TiZed/KReal/KReal.pdf

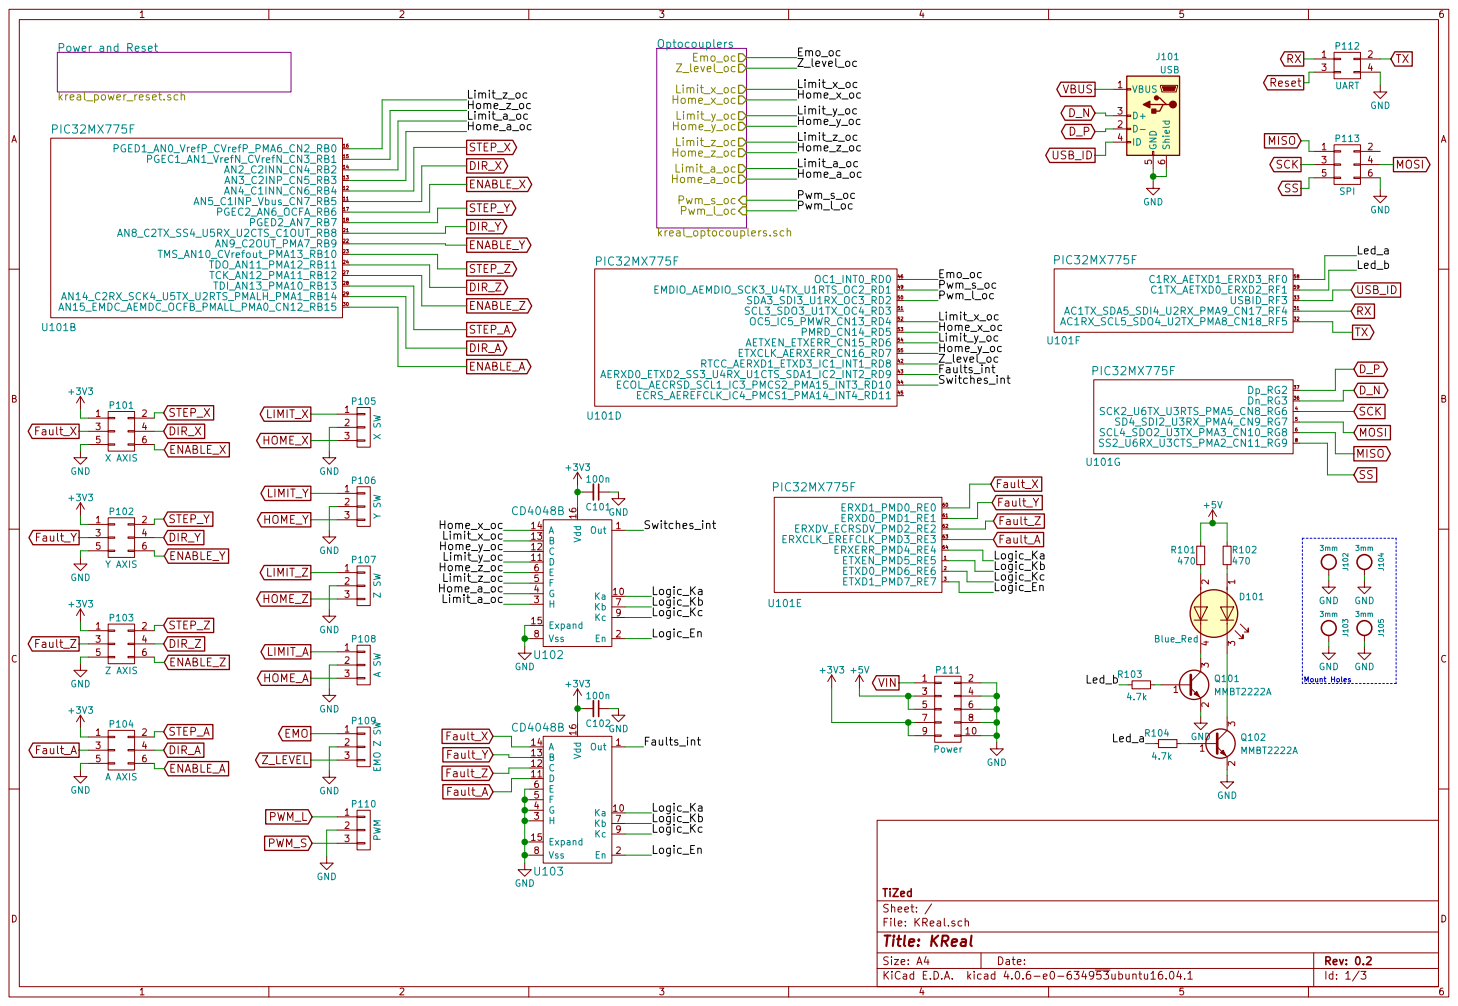
[picture p1: page 1]

Id: 1/3 Title: KReal File: KReal.sch Sheet: / TiZed Fault_X

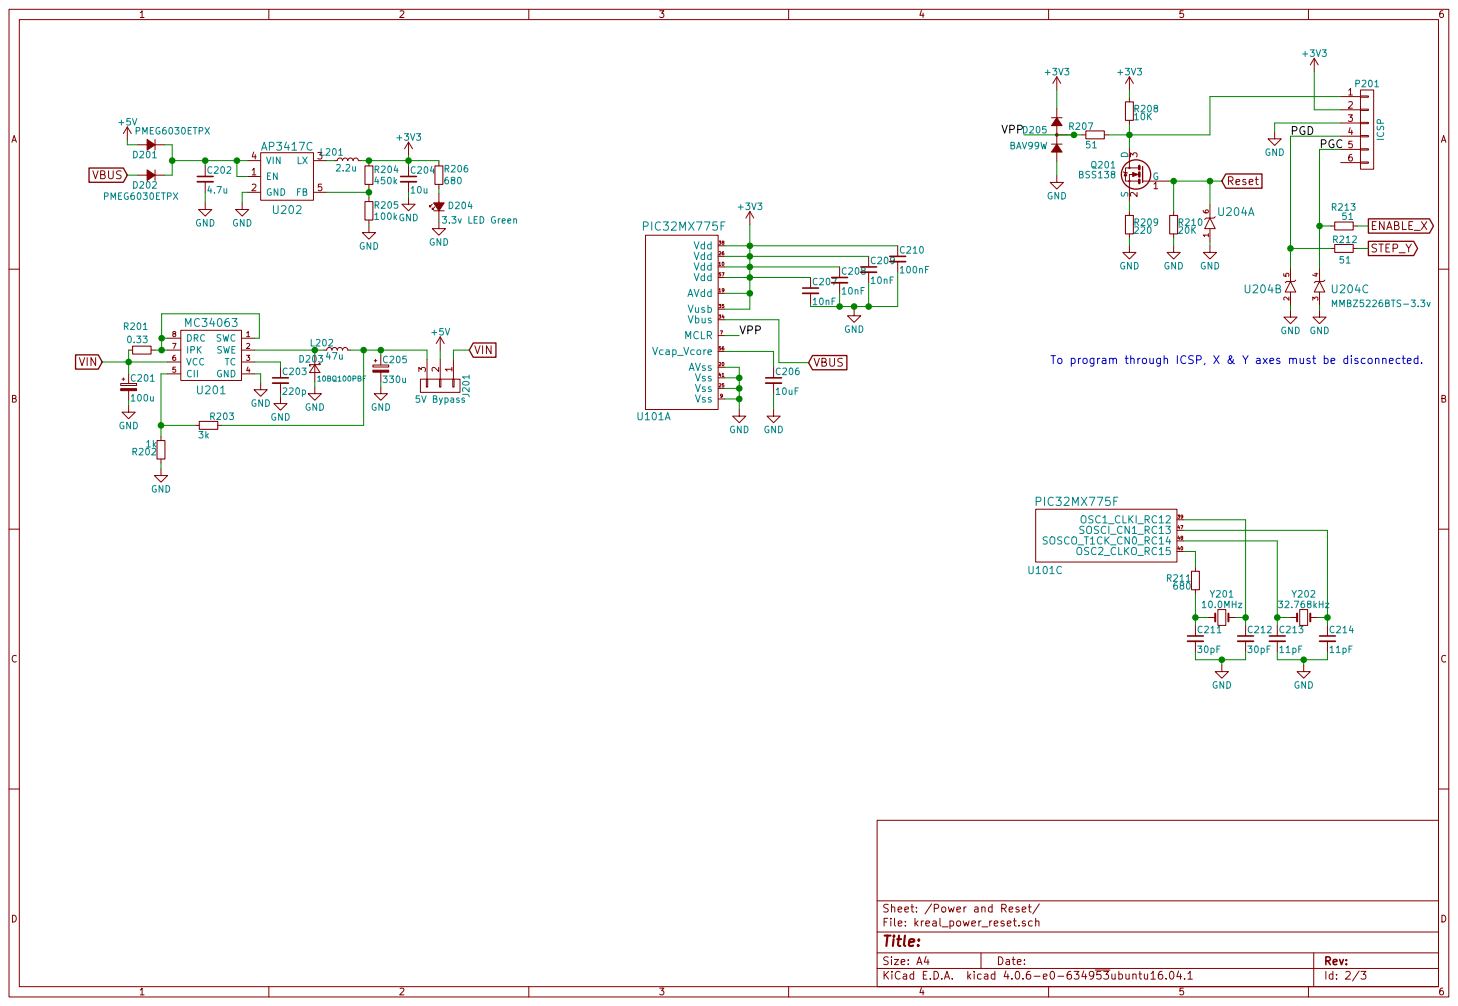
[picture p2: page 2]

10.0MHz To program through ICSP, X & Y axes must be disconnected.

File: kreal_power_reset.sch Sheet: /Power and Reset/
Id: 2/3 Title:

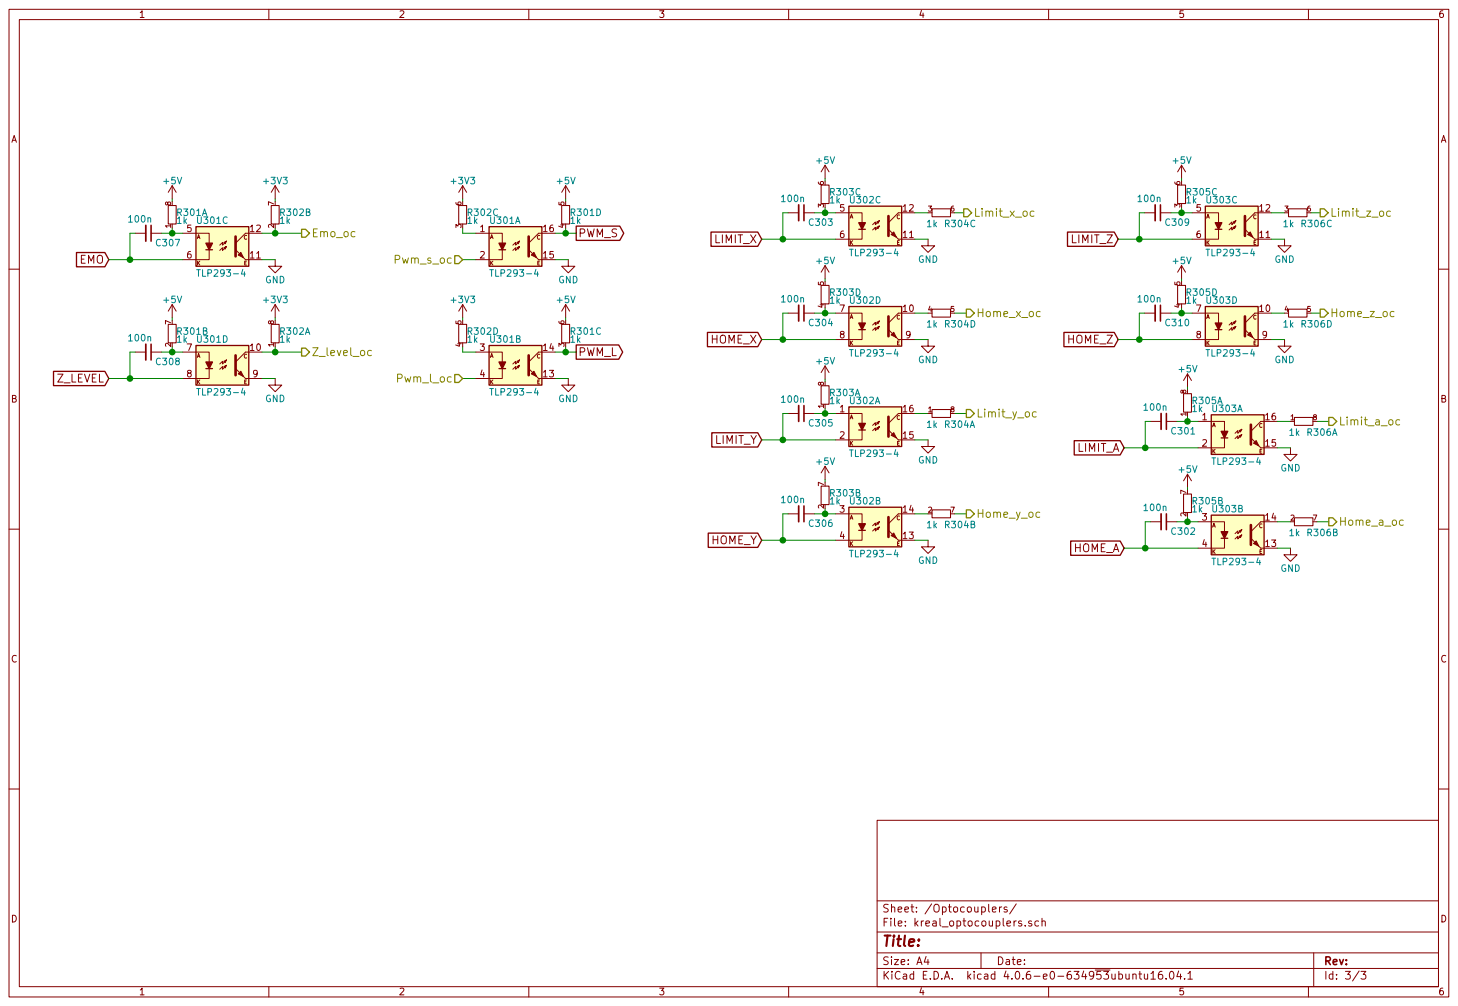
[picture p3: page 3]
