TiZed/KReal/KReal.kicad_pcb

## KiCad design KReal.kicad_pcb (2017-09-15)

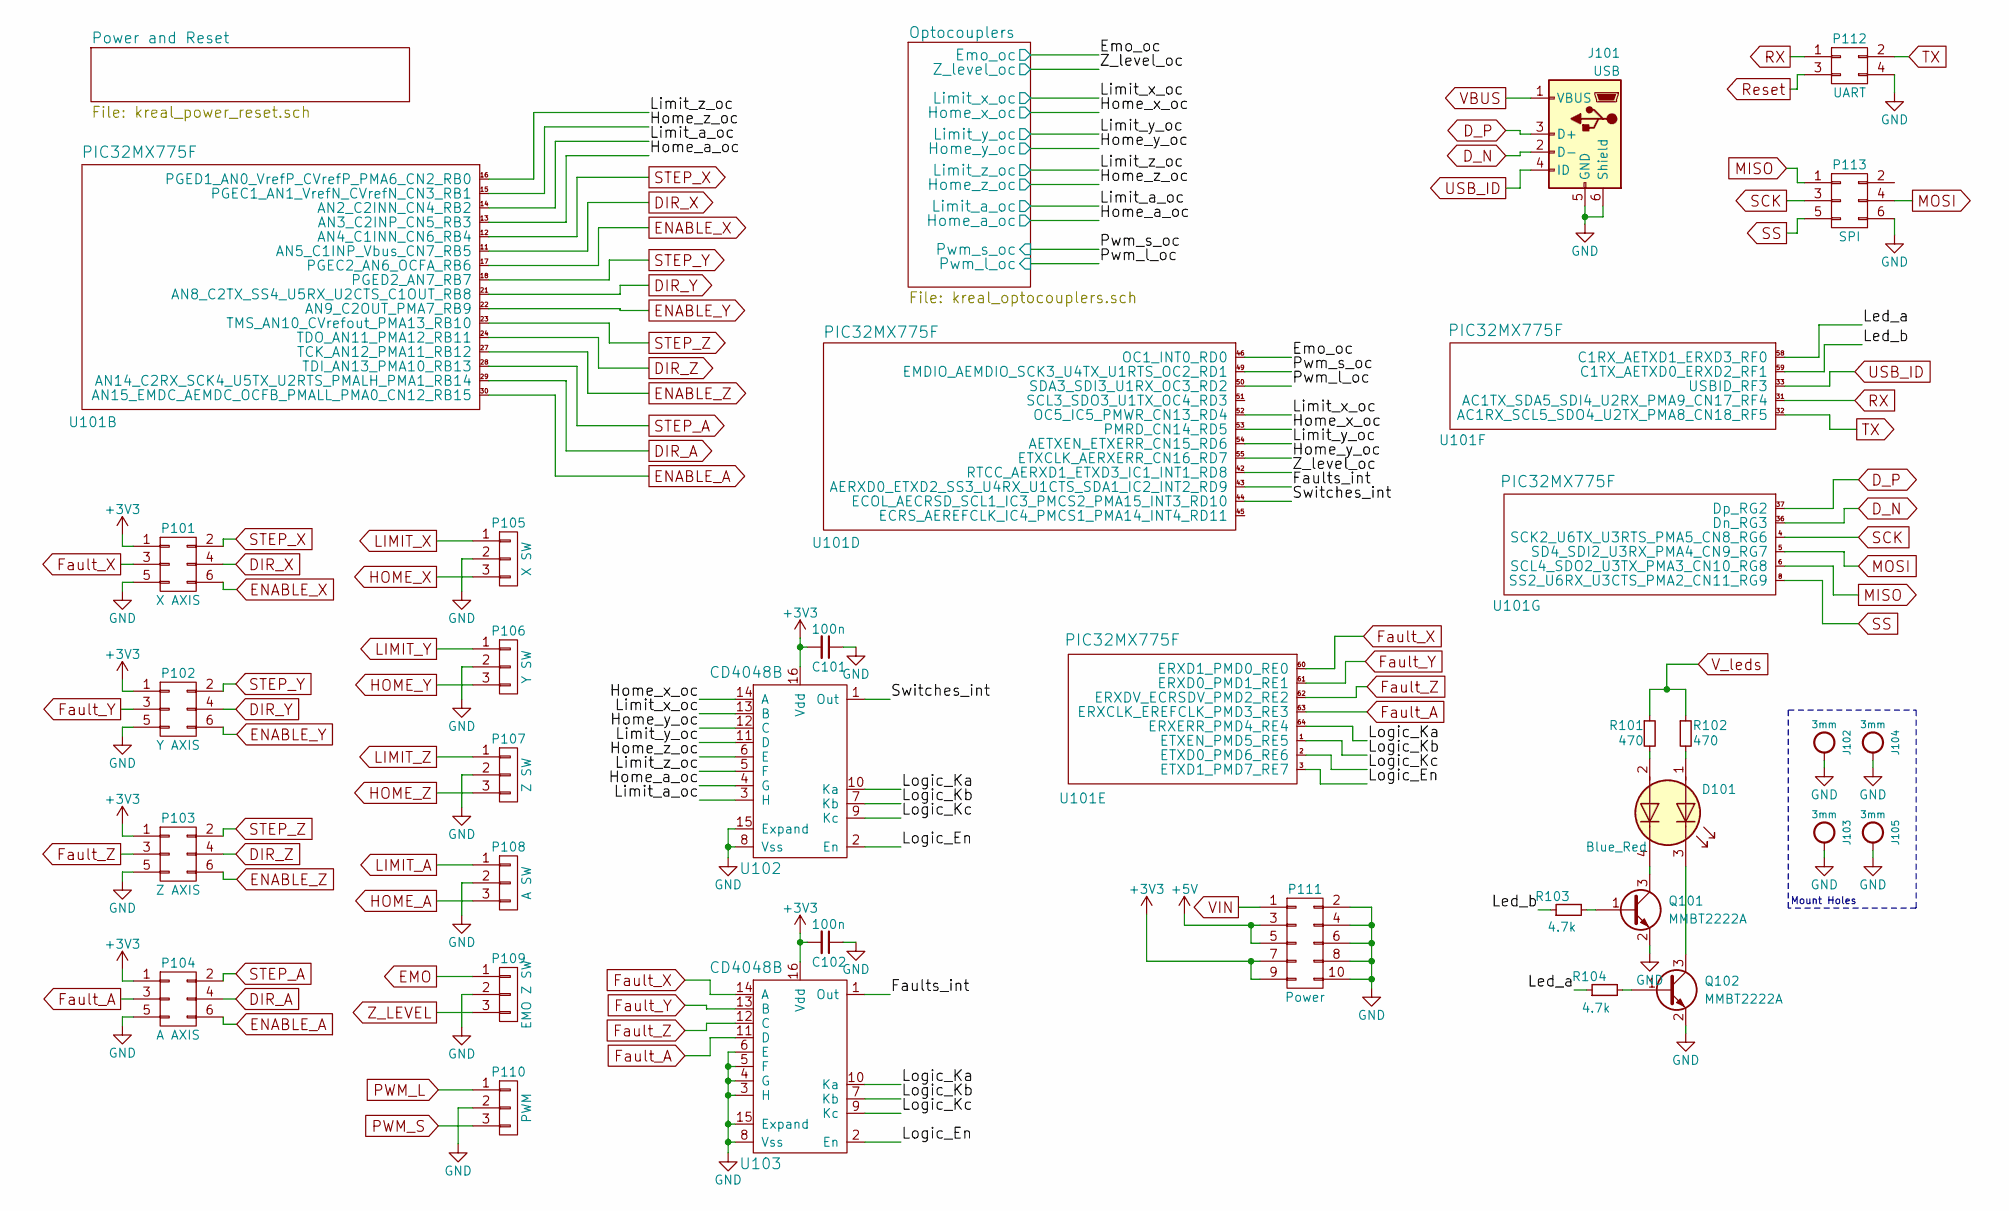
[picture p4: schematic KReal.sch]

Parts:
C101, C102: 100n; C_0603
D101: Blue_Red; LEDs_AACC_1.6mm_1.5mm
J101: USB; USB_Mini-B
J102, J103, J104, J105: 3mm; MountingHole_3mm_Pad
P101: X AXIS; Pin_Header_Straight_2x03_Pitch2.54mm
P102: Y AXIS; Pin_Header_Straight_2x03_Pitch2.54mm
P103: Z AXIS; Pin_Header_Straight_2x03_Pitch2.54mm
P104: A AXIS; Pin_Header_Straight_2x03_Pitch2.54mm
P105: X SW; Pin_Header_Straight_1x03_Pitch2.54mm
P106: Y SW; Pin_Header_Straight_1x03_Pitch2.54mm
P107: Z SW; Pin_Header_Straight_1x03_Pitch2.54mm
P108: A SW; Pin_Header_Straight_1x03_Pitch2.54mm
P109: EMO Z SW; Pin_Header_Straight_1x03_Pitch2.54mm
P110: PWM; Pin_Header_Straight_1x03_Pitch2.54mm
P111: Power; Pin_Header_Straight_2x05_Pitch2.54mm
P112: UART; Pin_Header_Straight_2x02_Pitch2.54mm
P113: SPI; Pin_Header_Straight_2x03_Pitch2.54mm
Q101, Q102: MMBT2222A; SOT-23
R101, R102: 470; R_0603
R103, R104: 4.7k; R_0603
U101: PIC32MX775F; TQFP-64_10x10mm_Pitch0.5mm
U102, U103: CD4048B; TSSOP-16_4.4x5mm_Pitch0.65mm

Connections:
+3V3: C101.2, C102.2, P101.1, P102.1, P103.1, P104.1, P111.7, P111.9, U102.16 (Vdd), U103.16 (Vdd); also elsewhere on the board
+5V: P111.3, P111.5; also elsewhere on the board
/Emo_oc: U101.46 (OC1_INT0_RD0); also elsewhere on the board
/Faults_int: U101.43 (AERXD0_ETXD2_SS3_U4RX_U1CTS_SDA1_IC2_IN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), U103.1 (Out)
/Home_a_oc: U101.13 (AN3_C2INP_CN5_RB3), U102.4 (G); also elsewhere on the board
/Home_x_oc: U101.53 (PMRD_CN14_RD5), U102.14 (A); also elsewhere on the board
/Home_y_oc: U101.55 (ETXCLK_AERXERR_CN16_RD7), U102.12 (C); also elsewhere on the board
/Home_z_oc: U101.15 (PGEC1_AN1_VrefN_CVrefN_CN3_RB1), U102.6 (E); also elsewhere on the board
/Led_a: R104.1, U101.58 (C1RX_AETXD1_ERXD3_RF0)
/Led_b: R103.1, U101.59 (C1TX_AETXD0_ERXD2_RF1)
/Limit_a_oc: U101.14 (AN2_C2INN_CN4_RB2), U102.3 (H); also elsewhere on the board
/Limit_x_oc: U101.52 (OC5_IC5_PMWR_CN13_RD4), U102.13 (B); also elsewhere on the board
/Limit_y_oc: U101.54 (AETXEN_ETXERR_CN15_RD6), U102.11 (D); also elsewhere on the board
/Limit_z_oc: U101.16 (PGED1_AN0_VrefP_CVrefP_PMA6_CN2_RB0), U102.5 (F); also elsewhere on the board
/Logic_En: U101.3 (ETXD1_PMD7_RE7), U102.2 (En), U103.2 (En)
/Logic_Ka: U101.64 (ERXERR_PMD4_RE4), U102.10 (Ka), U103.10 (Ka)
/Logic_Kb: U101.1 (ETXEN_PMD5_RE5), U102.7 (Kb), U103.7 (Kb)
/Logic_Kc: U101.2 (ETXD0_PMD6_RE6), U102.9 (Kc), U103.9 (Kc)
/Pwm_l_oc: U101.50 (SDA3_SDI3_U1RX_OC3_RD2); also elsewhere on the board
/Pwm_s_oc: U101.49 (EMDIO_AEMDIO_SCK3_U4TX_U1RTS_OC2_RD1); also elsewhere on the board
/Switches_int: U101.44 (ECOL_AECRSD_SCL1_IC3_PMCS2_PMA15_INT3_R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), U102.1 (Out)
/Z_level_oc: U101.42 (RTCC_AERXD1_ETXD3_IC1_INT1_RD8); also elsewhere on the board
DIR_A: P104.4, U101.29 (AN14_C2RX_SCK4_U5TX_U2RTS_PMALH_PMA1_RB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)
DIR_X: P101.4, U101.11 (AN5_C1INP_Vbus_CN7_RB5)
DIR_Y: P102.4, U101.21 (AN8_C2TX_SS4_U5RX_U2CTS_C1OUT_RB8)
DIR_Z: P103.4, U101.24 (TDO_AN11_PMA12_RB11)
D_N: J101.2 (D-), U101.36 (Dn_RG3)
D_P: J101.3 (D+), U101.37 (Dp_RG2)
EMO: P109.1; also elsewhere on the board
ENABLE_A: P104.6, U101.30 (AN15_EMDC_AEMDC_OCFB_PMALL_PMA0_CN12_RB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)
ENABLE_X: P101.6, U101.17 (PGEC2_AN6_OCFA_RB6); also elsewhere on the board
ENABLE_Y: P102.6, U101.22 (AN9_C2OUT_PMA7_RB9)
ENABLE_Z: P103.6, U101.27 (TCK_AN12_PMA11_RB12)
Fault_A: P104.3, U101.63 (ERXCLK_EREFCLK_PMD3_RE3), U103.11 (D)
Fault_X: P101.3, U101.60 (ERXD1_PMD0_RE0), U103.14 (A)
Fault_Y: P102.3, U101.61 (ERXD0_PMD1_RE1), U103.13 (B)
Fault_Z: P103.3, U101.62 (ERXDV_ECRSDV_PMD2_RE2), U103.12 (C)
GND: C101.1, C102.1, J101.5 (GND), J101.6 (Shield), J102.1, J103.1, J104.1, J105.1, P101.5, P102.5, P103.5, P104.5, P105.2, P106.2, P107.2, P108.2, P109.2, P110.2, P111.2, P111.4, P111.6, P111.8, P111.10, P112.4, P113.6, Q101.2 (E), Q102.2 (E), U102.8 (Vss), U102.15 (Expand), U103.3 (H), U103.4 (G), U103.5 (F), U103.6 (E), U103.8 (Vss), U103.15 (Expand); also elsewhere on the board
HOME_A: P108.3; also elsewhere on the board
HOME_X: P105.3; also elsewhere on the board
HOME_Y: P106.3; also elsewhere on the board
HOME_Z: P107.3; also elsewhere on the board
LIMIT_A: P108.1; also elsewhere on the board
LIMIT_X: P105.1; also elsewhere on the board
LIMIT_Y: P106.1; also elsewhere on the board
LIMIT_Z: P107.1; also elsewhere on the board
MISO: P113.1, U101.6 (SCL4_SDO2_U3TX_PMA3_CN10_RG8)
MOSI: P113.4, U101.5 (SD4_SDI2_U3RX_PMA4_CN9_RG7)
unnamed: D101.1 (A1), R102.2
unnamed: D101.2 (A2), R101.2
unnamed: D101.3 (K1), Q102.3 (C)
unnamed: D101.4 (K2), Q101.3 (C)
unnamed: Q101.1 (B), R103.2
unnamed: Q102.1 (B), R104.2
PWM_L: P110.1; also elsewhere on the board
PWM_S: P110.3; also elsewhere on the board
RX: P112.1, U101.31 (AC1TX_SDA5_SDI4_U2RX_PMA9_CN17_RF4)
Reset: P112.3; also elsewhere on the board
SCK: P113.3, U101.4 (SCK2_U6TX_U3RTS_PMA5_CN8_RG6)
SS: P113.5, U101.8 (SS2_U6RX_U3CTS_PMA2_CN11_RG9)
STEP_A: P104.2, U101.28 (TDI_AN13_PMA10_RB13)
STEP_X: P101.2, U101.12 (AN4_C1INN_CN6_RB4)
STEP_Y: P102.2, U101.18 (PGED2_AN7_RB7); also elsewhere on the board
STEP_Z: P103.2, U101.23 (TMS_AN10_CVrefout_PMA13_RB10)
TX: P112.2, U101.32 (AC1RX_SCL5_SDO4_U2TX_PMA8_CN18_RF5)
USB_ID: J101.4 (ID), U101.33 (USBID_RF3)
VBUS: J101.1 (VBUS); also elsewhere on the board
VIN: P111.1; also elsewhere on the board
V_leds: R101.1, R102.1; also elsewhere on the board
Z_LEVEL: P109.3; also elsewhere on the board

Notes on the sheet:
Mount Holes

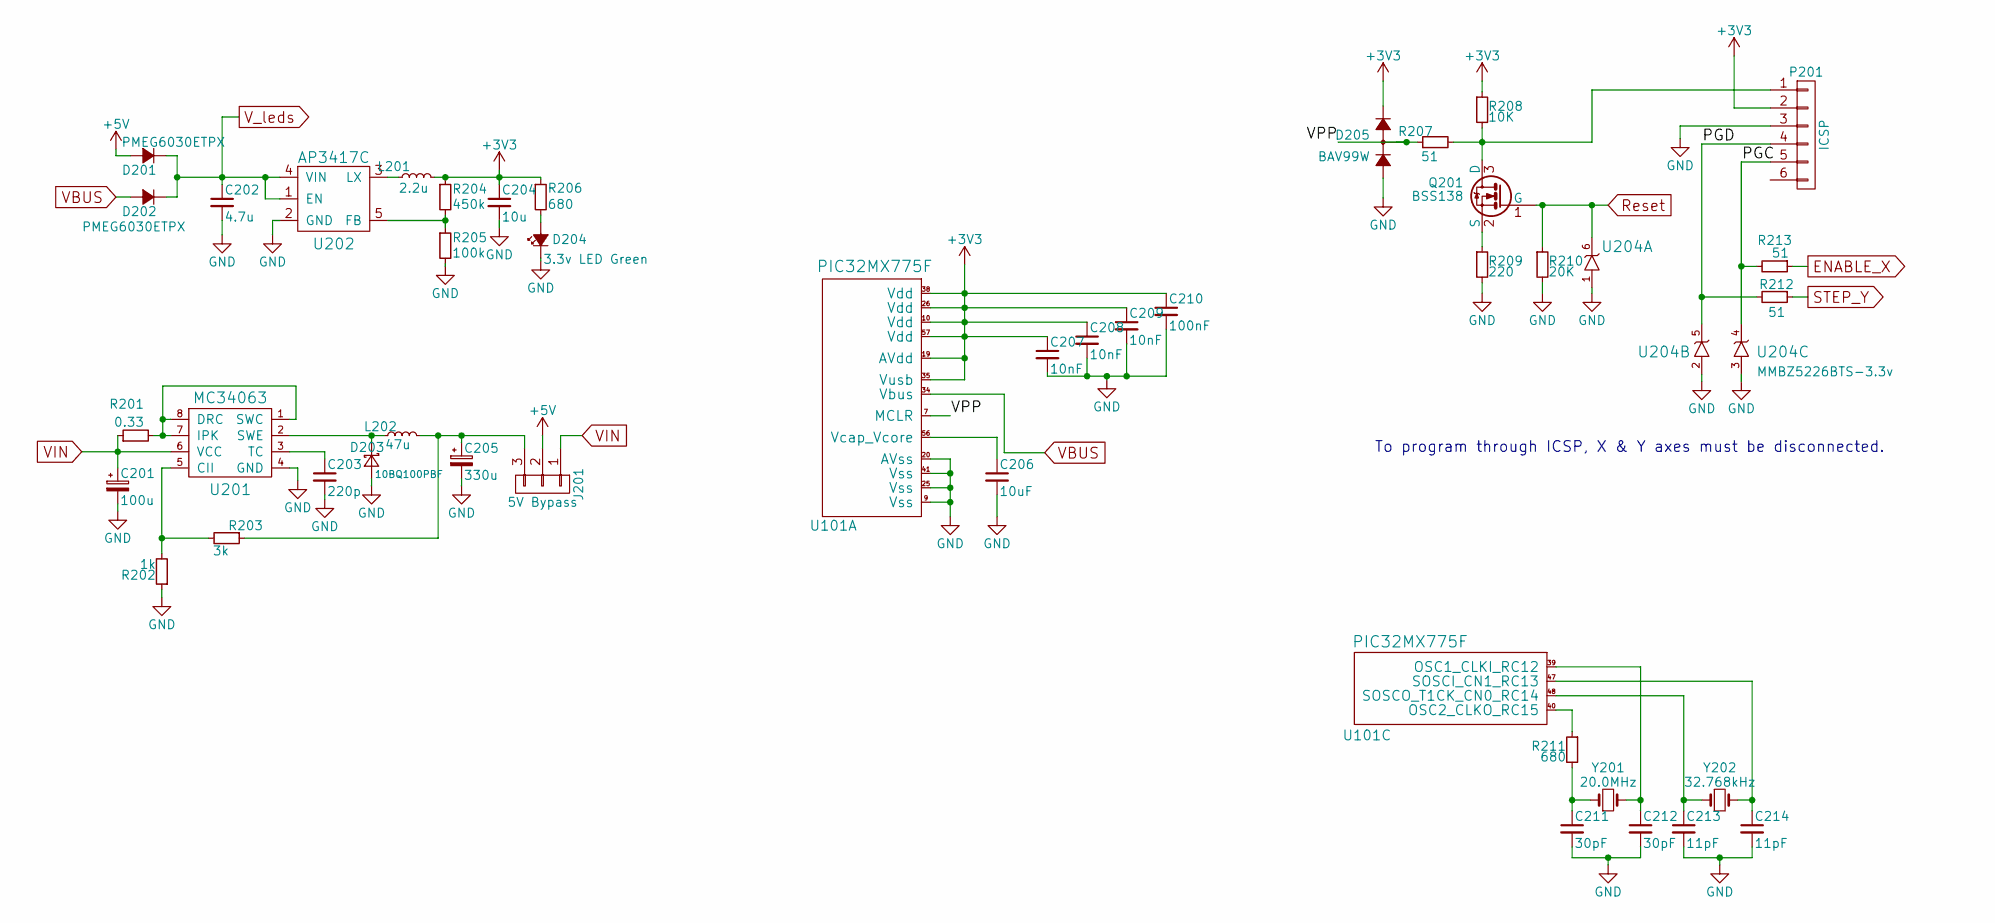
[picture p5: schematic kreal_power_reset.sch]

Parts:
C201: 100u; CP_Elec_6.3x7.7
C202: 4.7u; C_0603
C203: 220p; C_0603
C204: 10u; C_0603
C205: 330u; CP_Elec_8x10
C206: 10uF; C_0603
C207, C208, C209: 10nF; C_0603
C210: 100nF; C_0603
C211, C212: 30pF; C_0603
C213, C214: 11pF; C_0603
D201, D202: PMEG6030ETPX; D_SMA_Standard
D203: 10BQ100PBF; D_SMB_Standard
D204: 3.3v LED Green; LED_0603
D205: BAV99W; SOT-323_SC-70
J201: 5V Bypass; Pin_Header_Straight_1x03_Pitch2.54mm
L201: 2.2u; C_0805
L202: 47u; Inductor_Taiyo-Yuden_MD-5050
P201: ICSP; Pin_Header_Straight_1x06_Pitch2.54mm
Q201: BSS138; SOT-23
R201: 0.33; R_0805
R202: 1k; R_0603
R203: 3k; R_0603
R204: 450k; R_0603
R205: 100k; R_0603
R206, R211: 680; R_0603
R207, R212, R213: 51; R_0603
R208: 10K; R_0603
R209: 220; R_0603
R210: 20K; R_0603
U101: PIC32MX775F; TQFP-64_10x10mm_Pitch0.5mm
U201: MC34063; SOIC-8_3.9x4.9mm_Pitch1.27mm
U202: AP3417C; SOT-23-5
U204: MMBZ5226BTS-3.3v; SOT-363_SC-70-6
Y201: 20.0MHz; Crystal_SMD_0603-2pin_6.0x3.5mm
Y202: 32.768kHz; Crystal_SMD_MicroCrystal_CC5V-T1A-2pin_4.1x1.5mm

Connections:
+3V3: C204.1, C207.1, C208.1, C209.1, C210.1, D205.2 (A), L201.2, P201.2, R204.1, R206.1, R208.1, U101.10 (Vdd), U101.19 (AVdd), U101.26 (Vdd), U101.35 (Vusb), U101.38 (Vdd), U101.57 (Vdd); also elsewhere on the board
+5V: D201.2 (A), J201.2; also elsewhere on the board
/Power and Reset/PGC: P201.5, R213.2, U204.4
/Power and Reset/PGD: P201.4, R212.2, U204.5
/Power and Reset/VPP: D205.3 (AK), R207.1, U101.7 (MCLR)
ENABLE_X: R213.1; also elsewhere on the board
GND: C201.2, C202.2, C203.2, C204.2, C205.2, C206.2, C207.2, C208.2, C209.2, C210.2, C211.2, C212.2, C213.2, C214.2, D203.2 (A), D204.1 (K), D205.1 (K), P201.3, R202.1, R205.2, R209.2, R210.2, U101.9 (Vss), U101.20 (AVss), U101.25 (Vss), U101.41 (Vss), U201.4 (GND), U202.2 (GND), U204.1, U204.2, U204.3; also elsewhere on the board
unnamed: C203.1, U201.3 (TC)
unnamed: C205.1, J201.3, L202.2, R203.1
unnamed: C206.1, U101.56 (Vcap_Vcore)
unnamed: C211.1, R211.2, Y201.1
unnamed: C212.1, U101.39 (OSC1_CLKI_RC12), Y201.2
unnamed: C213.1, U101.48 (SOSCO_T1CK_CN0_RC14), Y202.1
unnamed: C214.1, U101.47 (SOSCI_CN1_RC13), Y202.2
unnamed: D203.1 (K), L202.1, U201.2 (SWE)
unnamed: D204.2 (A), R206.2
unnamed: L201.1, U202.3 (LX)
unnamed: P201.1, Q201.3 (D), R207.2, R208.2
unnamed: Q201.2 (S), R209.1
unnamed: R201.2, U201.1 (SWC), U201.7 (IPK), U201.8 (DRC)
unnamed: R202.2, R203.2, U201.5 (CII)
unnamed: R204.2, R205.1, U202.5 (FB)
unnamed: R211.1, U101.40 (OSC2_CLKO_RC15)
Reset: Q201.1 (G), R210.1, U204.6; also elsewhere on the board
STEP_Y: R212.1; also elsewhere on the board
VBUS: D202.2 (A), U101.34 (Vbus); also elsewhere on the board
VIN: C201.1, J201.1, R201.1, U201.6 (VCC); also elsewhere on the board
V_leds: C202.1, D201.1 (K), D202.1 (K), U202.1 (EN), U202.4 (VIN); also elsewhere on the board

Notes on the sheet:
To program through ICSP, X & Y axes must be disconnected.

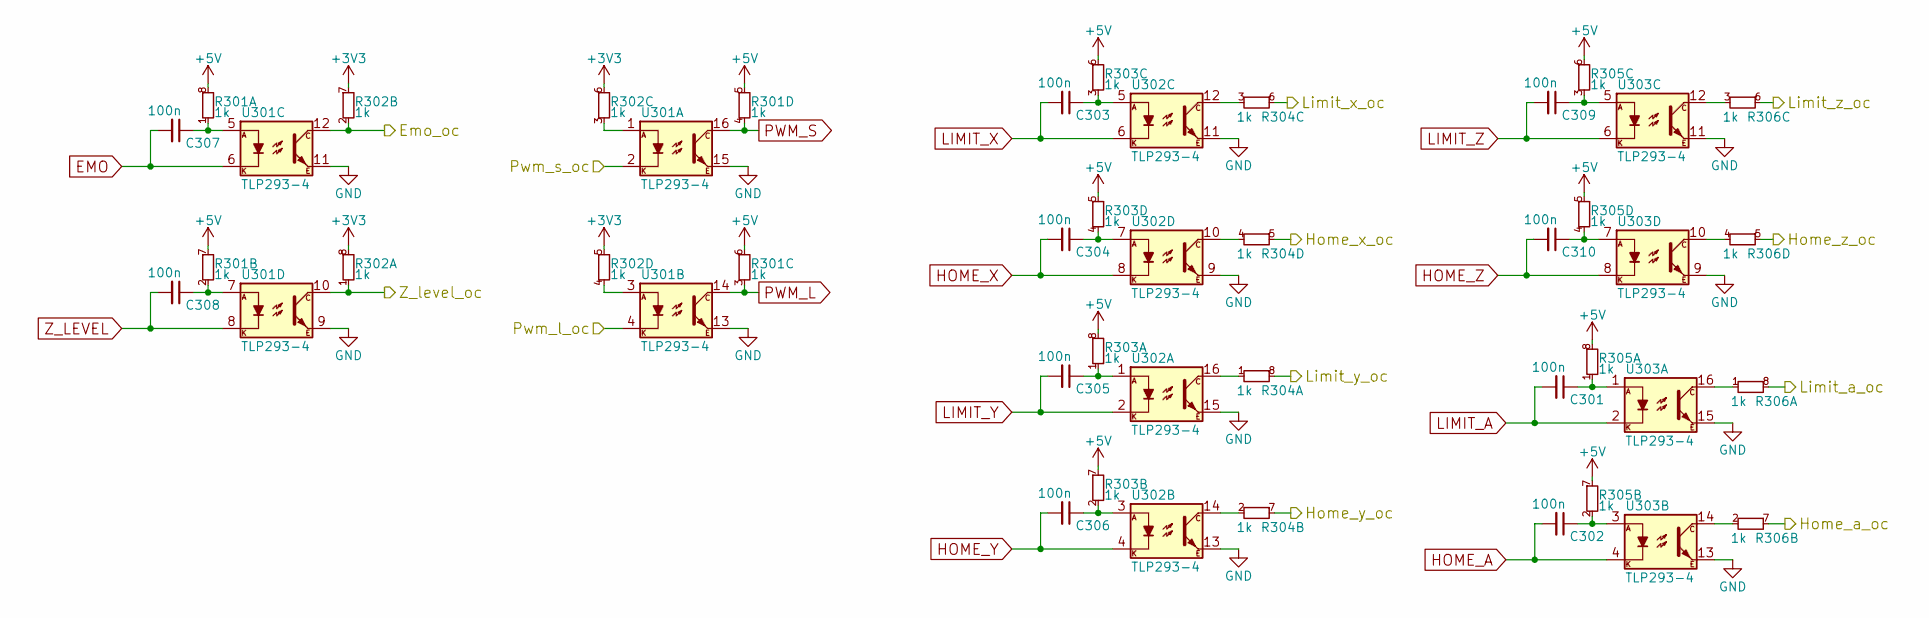
[picture p6: schematic kreal_optocouplers.sch]

Parts:
C301, C302, C303, C304, C305, C306, C307, C308, C309, C310: 100n; C_0603
R301, R302, R303, R304, R305, R306: 1k; R_Array_Concave_4x0603
U301, U302, U303: TLP293-4; SO-16-N

Connections:
+3V3: R302.5, R302.6, R302.7, R302.8; also elsewhere on the board
+5V: R301.5, R301.6, R301.7, R301.8, R303.5, R303.6, R303.7, R303.8, R305.5, R305.6, R305.7, R305.8; also elsewhere on the board
/Emo_oc: R302.2, U301.12; also elsewhere on the board
/Home_a_oc: R306.7; also elsewhere on the board
/Home_x_oc: R304.5; also elsewhere on the board
/Home_y_oc: R304.7; also elsewhere on the board
/Home_z_oc: R306.5; also elsewhere on the board
/Limit_a_oc: R306.8; also elsewhere on the board
/Limit_x_oc: R304.6; also elsewhere on the board
/Limit_y_oc: R304.8; also elsewhere on the board
/Limit_z_oc: R306.6; also elsewhere on the board
/Pwm_l_oc: U301.4; also elsewhere on the board
/Pwm_s_oc: U301.2; also elsewhere on the board
/Z_level_oc: R302.1, U301.10; also elsewhere on the board
EMO: C307.2, U301.6; also elsewhere on the board
GND: U301.9, U301.11, U301.13, U301.15, U302.9, U302.11, U302.13, U302.15, U303.9, U303.11, U303.13, U303.15; also elsewhere on the board
HOME_A: C302.2, U303.4; also elsewhere on the board
HOME_X: C304.2, U302.8; also elsewhere on the board
HOME_Y: C306.2, U302.4; also elsewhere on the board
HOME_Z: C310.2, U303.8; also elsewhere on the board
LIMIT_A: C301.2, U303.2; also elsewhere on the board
LIMIT_X: C303.2, U302.6; also elsewhere on the board
LIMIT_Y: C305.2, U302.2; also elsewhere on the board
LIMIT_Z: C309.2, U303.6; also elsewhere on the board
unnamed: C301.1, R305.1, U303.1
unnamed: C302.1, R305.2, U303.3
unnamed: C303.1, R303.3, U302.5
unnamed: C304.1, R303.4, U302.7
unnamed: C305.1, R303.1, U302.1
unnamed: C306.1, R303.2, U302.3
unnamed: C307.1, R301.1, U301.5
unnamed: C308.1, R301.2, U301.7
unnamed: C309.1, R305.3, U303.5
unnamed: C310.1, R305.4, U303.7
unnamed: R302.3, U301.1
unnamed: R302.4, U301.3
unnamed: R304.1, U302.16
unnamed: R304.2, U302.14
unnamed: R304.3, U302.12
unnamed: R304.4, U302.10
unnamed: R306.1, U303.16
unnamed: R306.2, U303.14
unnamed: R306.3, U303.12
unnamed: R306.4, U303.10
PWM_L: R301.3, U301.14; also elsewhere on the board
PWM_S: R301.4, U301.16; also elsewhere on the board
Z_LEVEL: C308.2, U301.8; also elsewhere on the board

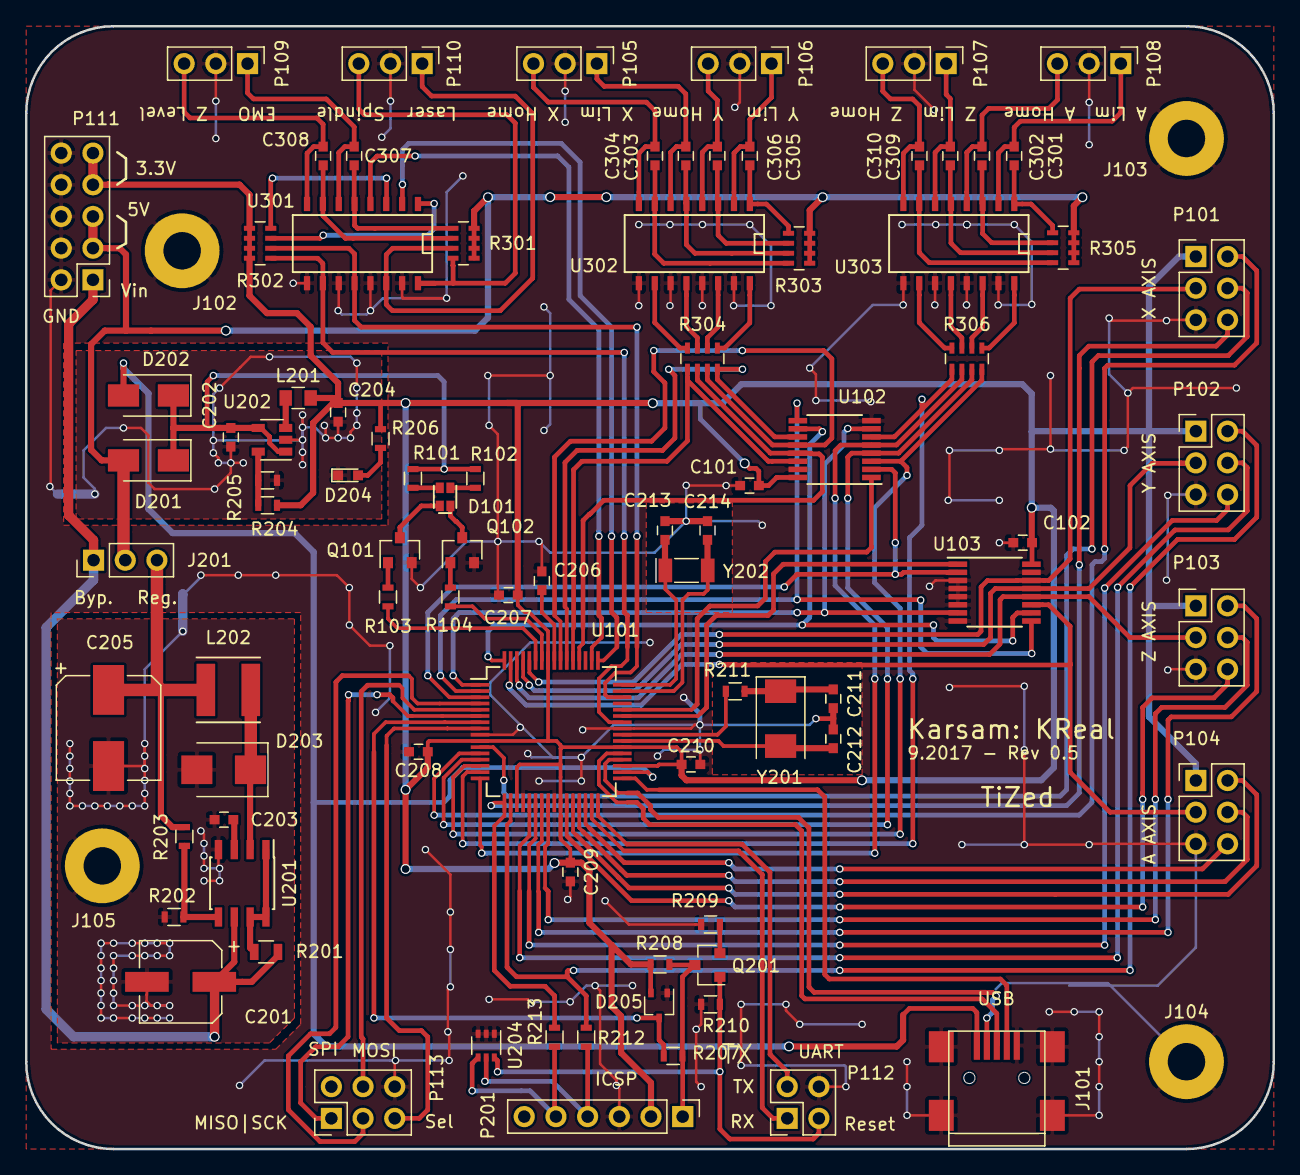
[picture p7: board KReal.kicad_pcb from above]

Board: 2 copper layers, 100.0 x 90.0 mm, 91 parts (0 on the bottom side), 109 nets.
