TiZed/KReal/Firmware/kreal.h

/* 
 * karsam_uno.h - Step generator for Machinekit
 *
 * Created on 1 July 2017
 * 
 *  Copyright (C) 2017 TiZed
 *
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
 * ----------------------------------------------------------------------------
 */

#ifndef KARSAM_UNO_H
#define	KARSAM_UNO_H

#ifdef	__cplusplus
extern "C" {
#endif
    
#define SYS_FREQ (80000000L)
#define PB_CLOCK (SYS_FREQ / (1 << OSCCONbits.PBDIV))
#define CORE_TIMER_FREQ (SYS_FREQ / 2)

#define FLASH_SPEED_HZ          30000000 //Max Flash speed
#define PB_BUS_MAX_FREQ_HZ      80000000 //Max Peripheral bus speed
    
#define BUFFER_SIZE     (50)

// Commands
#define CMD_CFG     0x47464323    // #CFG
#define CMD_UPD     0x44505523    // #UPD
#define CMD_STP     0x50545323    // #STP
#define CMD_CHK     0x4b484323    // #CHK
#define CMD_NUL     0x00000000    // Dummy NULL command
    
void set_switch(uint32_t axis, uint32_t type) ;
void clr_switch(uint32_t axis, uint32_t type) ;
void all_stop() ;
void update_switches() ;

#define SWAP_BYTES(IN)  IN << 24 | (IN & 0xff00) << 8 | (IN & 0xff0000) >> 8 | IN >> 24

uint32_t __attribute__((nomips16))  enableInterrupts(void)
{
    uint32_t status = 0 ;
    asm volatile("ei    %0" : "=r"(status)) ;
    return status ;
}

uint32_t __attribute__((nomips16)) disableInterrupts(void)
{
    uint32_t status = 0 ;
    asm volatile("di    %0" : "=r"(status)) ;
    return status ;
}

void __attribute__((nomips16))  restoreInterrupts(uint32_t st)
{
    if (st & 0x00000001) asm volatile("ei") ;
    else asm volatile("di") ;
}

extern __inline__ unsigned int __attribute__((always_inline)) _VirtToPhys(const void * p)
{
    return (int)p < 0 ? ((int)p & 0x1fffffffL) : (unsigned int)((unsigned char*)p + 0x40000000L);
}

#ifdef	__cplusplus
}
#endif

#endif	/* KARSAM_UNO_H */
