TiZed/KReal/Firmware/uint_buffer.h

/*
 * Buffer.h - Simple ring buffer for serial I/O
 *
 *  Created on: Nov 10, 2014
 *
 *  Copyright (C) 2014-2015  TiZed
 *
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
 */

#ifndef BUFFER_H_
#define BUFFER_H_

#include <p32xxxx.h>
#include <stdint.h>

typedef struct {
	unsigned int * data  ;
	volatile unsigned int head ;
	volatile unsigned int tail ;
	const unsigned int size ;
} Buffer ;

#define BUFFER(NAME, SIZE) \
    unsigned int NAME ## _da[SIZE] ; \
    Buffer NAME = {NAME ## _da, 0, 0, SIZE} ; \

static inline unsigned int __attribute__((always_inline)) isEmpty(Buffer * buffer)
{
    return(buffer->head == buffer->tail) ;
}

static inline unsigned int __attribute__((always_inline)) isFull(Buffer * buffer)
{
    return((buffer->head + 1) % buffer->size == buffer->tail) ;
}

static inline void __attribute__((always_inline)) push(Buffer * buffer, unsigned int value) {
    if(isFull(buffer)) return ;
    buffer->data[buffer->head] = value ;
    buffer->head = (buffer->head + 1) % buffer->size ;
}

static inline unsigned int __attribute__((always_inline)) pop(Buffer * buffer) {
    if(isEmpty(buffer)) return (0) ;
    unsigned int ret_val = buffer->data[buffer->tail] ;
    buffer->tail = (buffer->tail + 1) % buffer->size ;
    return(ret_val) ;
}

static inline unsigned int __attribute__((always_inline)) pop_wait(Buffer * buffer) {
    while(isEmpty(buffer)) WDTCONSET = 1 ;
    unsigned int ret_val = buffer->data[buffer->tail] ;
    buffer->tail = (buffer->tail + 1) % buffer->size ;
    return(ret_val) ;
}

static inline void __attribute__((always_inline)) set_head(Buffer * buffer, unsigned int value) {
    buffer->head = value % buffer->size ; 
}

static inline void __attribute__((always_inline)) set_tail(Buffer * buffer, unsigned int value) {
    buffer->tail = value % buffer->size ; 
}

static inline void __attribute__((always_inline)) clear(Buffer * buffer) {
    buffer->head = buffer->tail ;
}

unsigned int peek(Buffer * buffer) {
    if(isEmpty(buffer)) return(0) ;
    unsigned int ret_val = buffer->data[buffer->tail] ;
    return(ret_val) ;
}

#endif /* BUFFER_H_ */
