TiZed/KReal/(commit log)

2017-05-26 First commit: PCB done, FW to follow
    [KReal.kicad_pcb, KReal.sch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]
2017-06-20 Added schematic PDF
2017-07-08 Adding SPI DMA transfer
2017-07-31 Continue SPI DMA code
2017-09-15 Fixed swapped USB N and P lanes in schematic. NOT fixed in layout yet.
    [KReal.sch, kreal_optocouplers.sch, kreal_power_reset.sch]
2017-09-15 Fixed USB in layout. Fixed LEDs power source.
    [KReal.kicad_pcb, KReal.sch, kreal_optocouplers.sch, kreal_power_reset.sch]
2017-09-20 Added CD4048B IC control. Changing switches and interrupts.
2017-09-21 Added external interrupts. Optimized SPI protocol.
2017-09-23 Added axis 'fault' signal setup. Added LEDs contorl
2017-09-25 Fixed interrupts clearing. Activated secondary oscillator.
    [kreal.c]
2017-09-30 Added LEDs blink. Some fixes to DMA and SPI configurations.
    [axis.h, kreal.c, leds.h, pwm.h]
2017-10-06 Errata WA. Some minor optimization
    [kreal.c]
2017-10-07 Finally got the DMA <-> SPI to work.
2017-10-08 Fixed interrupt edges. Some cleanup
    [kreal.c]
2017-10-10 Logic fix for Logic IC.
    [cd4048b.c, kreal.c]
2017-11-01 Fixed SPI padding and offsets bug
    [kreal.c, uint_buffer.h]
2017-11-15 Bytes swap done by DMA. Velocity command is now 64bits
    [axis.c, axis.h, kreal.c]
2017-11-18 Some fixes due to HAL changes
    [axis.c, axis.h, kreal.c]
2017-11-20 Fixed missing enabled check in stepgen
    [axis.c, axis.h]
2017-11-25 Inverted axes, added invert option
    [axis.c, axis.h, kreal.c]
2017-11-26 Some fixed to PWM
    [kreal.c, pwm.c, pwm.h]
2017-11-27 Fixed tx checksum offset. Improved PWM rx loop.
    [kreal.c]
2017-12-02 Fixed PWM frequency
2017-12-07 Fixed Z-Probe stuck on '1'
    [kreal.c]
2017-12-11 Removed switches interrupt, now works by polling
2018-01-20 Fixed Z-Probe latchup and xsum race condition
    [kreal.c]
